zachlambert/pcb-mobile-robot/base/mobile_robot.kicad_pcb

## KiCad design base/mobile_robot.kicad_pcb (2022-08-06)

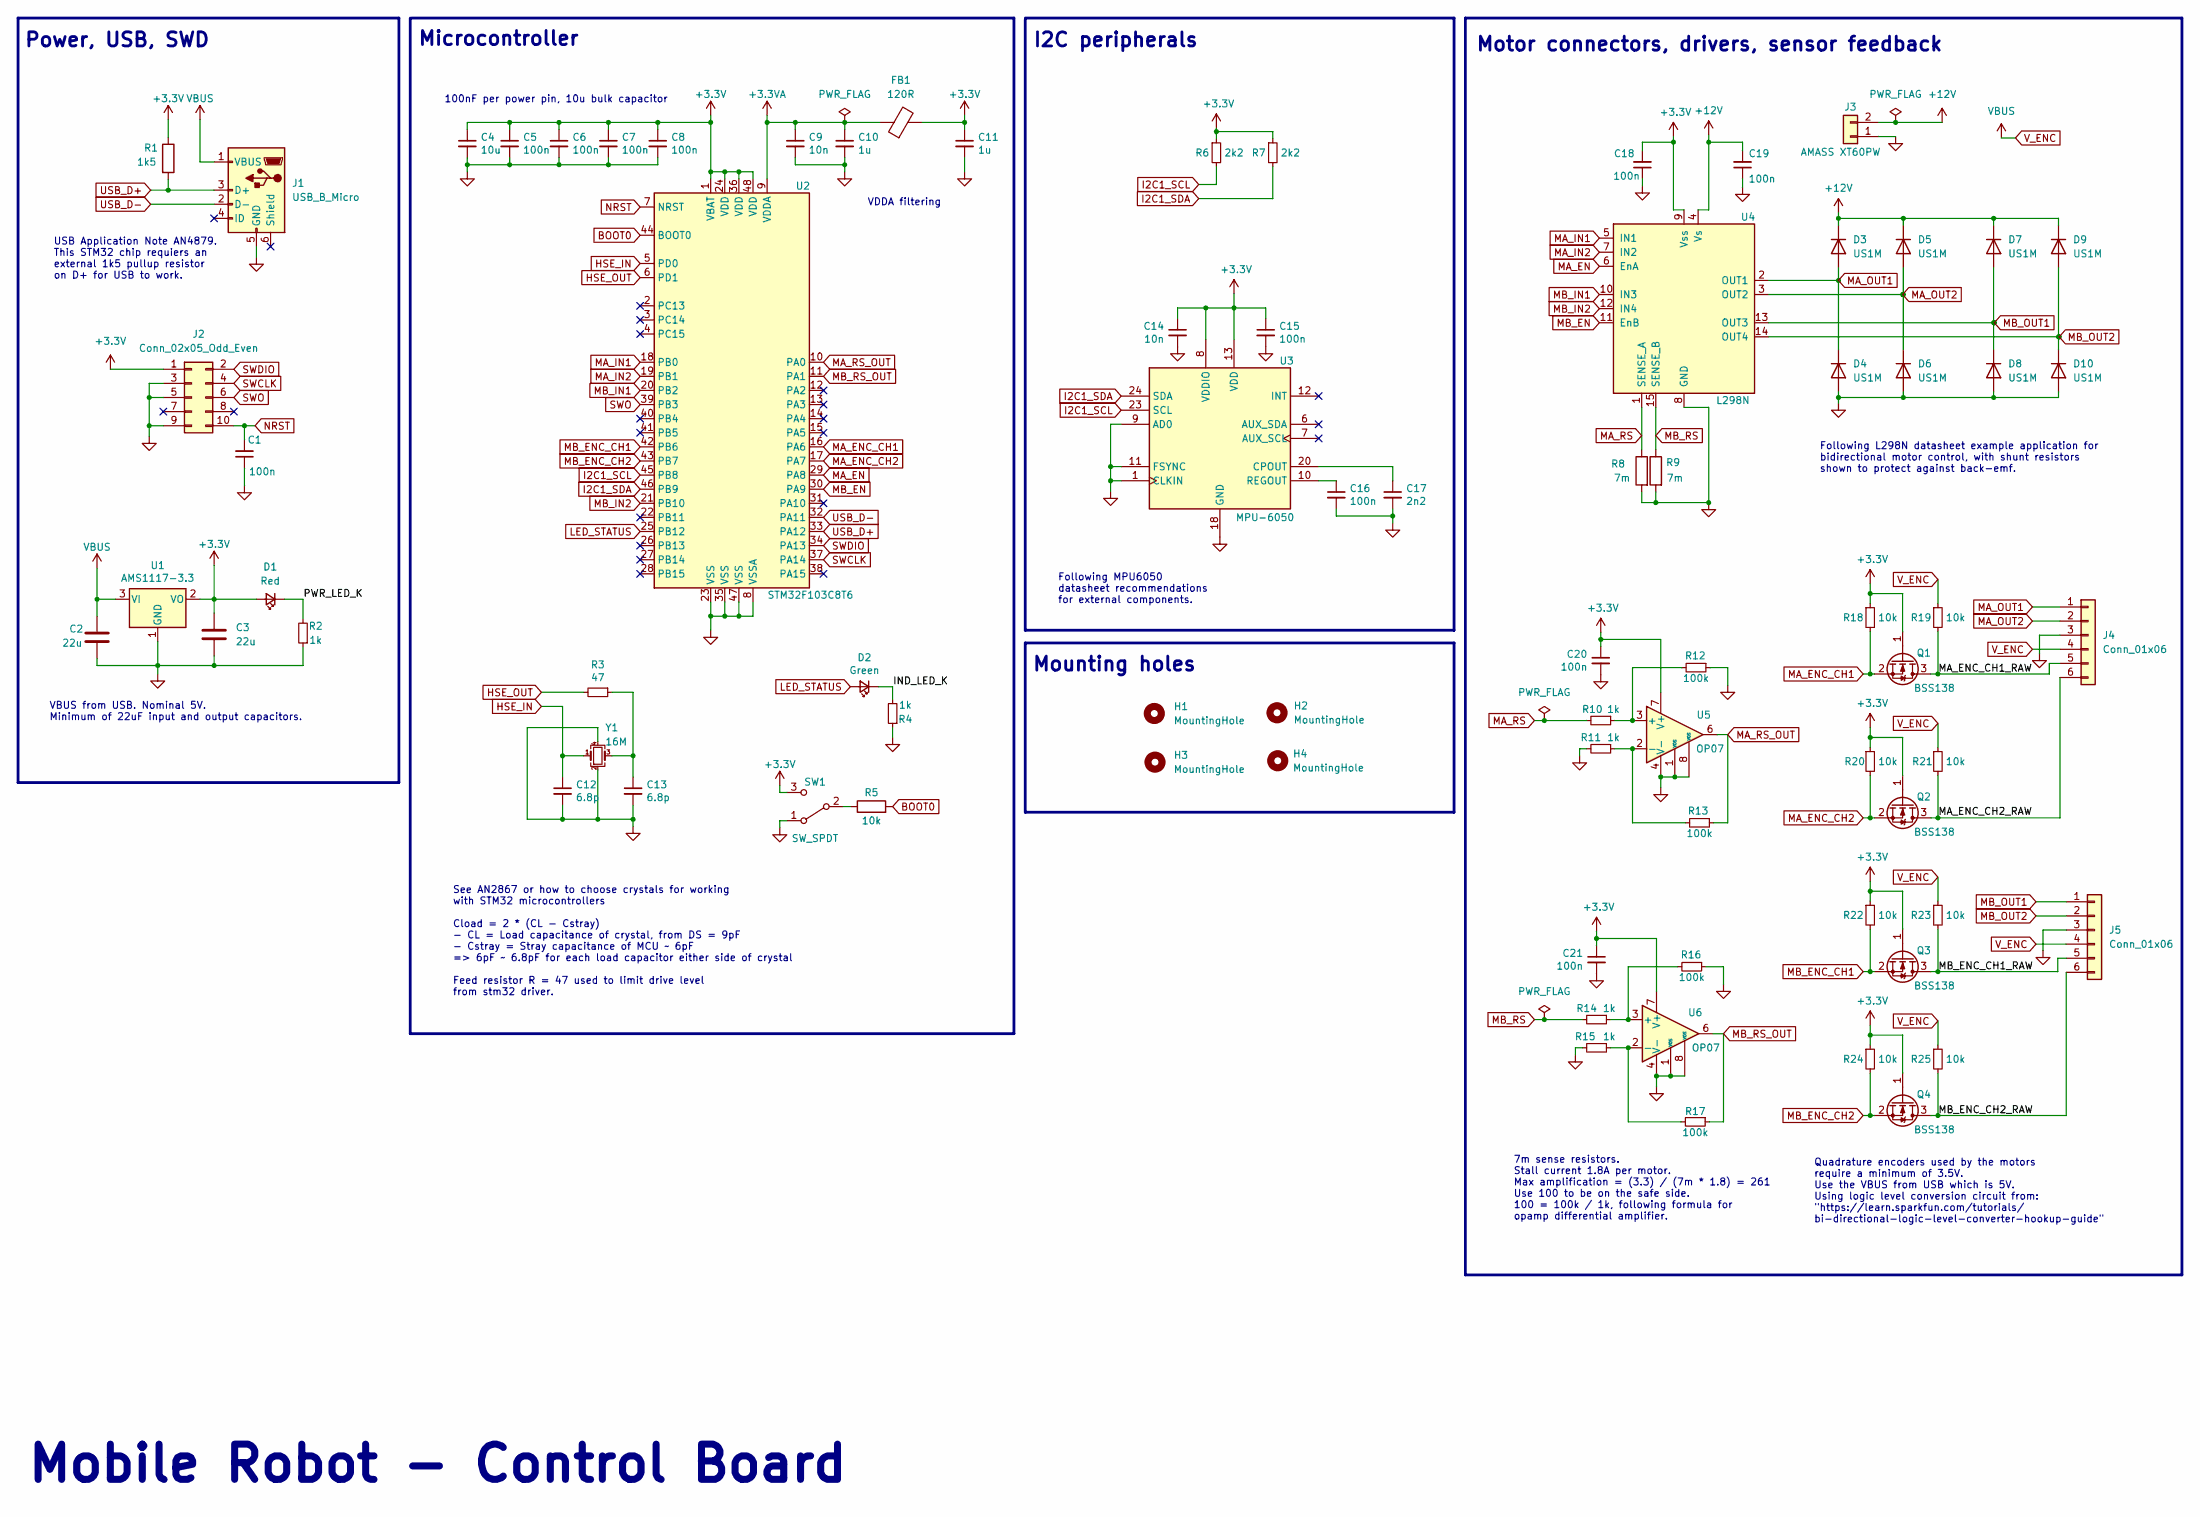
[picture p1: schematic mobile_robot.kicad_sch, Mobile Robot - Control Board]

Parts:
C1, C5, C6, C7, C8, C15, C16, C18, C19, C20, C21: 100n; C_0402_1005Metric
C2, C3: 22u; C_0805_2012Metric
C4: 10u; C_0603_1608Metric
C9, C14: 10n; C_0402_1005Metric
C10, C11: 1u; C_0402_1005Metric
C12, C13: 6.8p; C_0402_1005Metric
C17: 2n2; C_0402_1005Metric
D1: Red; D_0603_1608Metric
D2: Green; D_0603_1608Metric
D3, D4, D5, D6, D7, D8, D9, D10: US1M; D_SMA
FB1: 120R; L_0603_1608Metric
H1, H2, H3, H4: MountingHole; MountingHole_3.2mm_M3
J1: USB_B_Micro; USB_Micro-B_Molex_47346-0001
J2: Conn_02x05_Odd_Even; PinHeader_2x05_P2.54mm_Vertical
J3: AMASS XT60PW; AMASS_XT60PW-M
J4, J5: Conn_01x06; PinHeader_1x06_P2.54mm_Vertical
Q1, Q2, Q3, Q4: BSS138; SOT-23
R1: 1k5; R_0402_1005Metric
R2, R4, R10, R11, R14, R15: 1k; R_0402_1005Metric
R3: 47; R_0402_1005Metric
R5, R18, R19, R20, R21, R22, R23, R24, R25: 10k; R_0402_1005Metric
R6, R7: 2k2; R_0402_1005Metric
R8, R9: 7m; R_2512_6332Metric
R12, R13, R16, R17: 100k; R_0402_1005Metric
SW1: SW_SPDT; SW_SPDT_PCM12
U1: AMS1117-3.3; SOT-223-3_TabPin2
U2: STM32F103C8T6; LQFP-48_7x7mm_P0.5mm
U3: MPU-6050; InvenSense_QFN-24_4x4mm_P0.5mm
U4: L298N; TO-220-15_P2.54x2.54mm_StaggerOdd_Lead4.58mm_Vertical
U5, U6: OP07; SOIC-8_3.9x4.9mm_P1.27mm
Y1: 16M; Crystal_SMD_3225-4Pin_3.2x2.5mm

Connections:
+3.3VA: C9.1, C10.1, FB1.1, U2.9 (VDDA)
+3V3: C3.1, C4.1, C5.1, C6.1, C7.1, C8.1, C11.1, C14.1, C15.1, C18.2, C20.1, C21.1, D1.2 (A), FB1.2, J2.1, Q1.1 (G), Q2.1 (G), Q3.1 (G), Q4.1 (G), R1.1, R6.1, R7.1, R18.1, R20.1, R22.1, R24.1, SW1.3 (C), U1.2 (VO), U2.1 (VBAT), U2.24 (VDD), U2.36 (VDD), U2.48 (VDD), U3.8 (VDDIO), U3.13 (VDD), U4.9 (Vss), U5.7 (V+), U6.7 (V+)
+12V: C19.2, D3.1 (K), D5.1 (K), D7.1 (K), D9.1 (K), J3.2, U4.4 (Vs)
/IND_LED_K: D2.1 (K), R4.2
/MA_ENC_CH1_RAW: J4.5, Q1.3 (D), R19.2
/MA_ENC_CH2_RAW: J4.6, Q2.3 (D), R21.2
/MB_ENC_CH1_RAW: J5.5, Q3.3 (D), R23.2
/MB_ENC_CH2_RAW: J5.6, Q4.3 (D), R25.2
/PWR_LED_K: D1.1 (K), R2.2
BOOT0: R5.2, U2.44 (BOOT0)
GND: C1.1, C2.2, C3.2, C4.2, C5.2, C6.2, C7.2, C8.2, C9.2, C10.2, C11.2, C12.2, C13.2, C14.2, C15.2, C16.2, C17.2, C18.1, C19.1, C20.2, C21.2, D4.2 (A), D6.2 (A), D8.2 (A), D10.2 (A), J1.5 (GND), J2.3, J2.5, J2.9, J3.1, J4.3, J5.3, R2.1, R4.1, R8.2, R9.2, R11.2, R12.1, R15.2, R16.1, SW1.1 (A), U1.1 (GND), U2.8 (VSSA), U2.23 (VSS), U2.35 (VSS), U2.47 (VSS), U3.1 (CLKIN), U3.9 (AD0), U3.11 (FSYNC), U3.18 (GND), U4.8 (GND), U5.1 (VOS), U5.4 (V-), U5.8 (VOS), U6.1 (VOS), U6.4 (V-), U6.8 (VOS), Y1.2, Y1.4
HSE_IN: C12.1, U2.5 (PD0), Y1.1
HSE_OUT: R3.2, U2.6 (PD1)
I2C1_SCL: R6.2, U2.45 (PB8), U3.23 (SCL)
I2C1_SDA: R7.2, U2.46 (PB9), U3.24 (SDA)
LED_STATUS: D2.2 (A), U2.25 (PB12)
MA_EN: U2.29 (PA8), U4.6 (EnA)
MA_ENC_CH1: Q1.2 (S), R18.2, U2.16 (PA6)
MA_ENC_CH2: Q2.2 (S), R20.2, U2.17 (PA7)
MA_IN1: U2.18 (PB0), U4.5 (IN1)
MA_IN2: U2.19 (PB1), U4.7 (IN2)
MA_OUT1: D3.2 (A), D4.1 (K), J4.1, U4.2 (OUT1)
MA_OUT2: D5.2 (A), D6.1 (K), J4.2, U4.3 (OUT2)
MA_RS: R8.1, R10.2, U4.1 (SENSE_A)
MA_RS_OUT: R13.1, U2.10 (PA0), U5.6
MB_EN: U2.30 (PA9), U4.11 (EnB)
MB_ENC_CH1: Q3.2 (S), R22.2, U2.42 (PB6)
MB_ENC_CH2: Q4.2 (S), R24.2, U2.43 (PB7)
MB_IN1: U2.20 (PB2), U4.10 (IN3)
MB_IN2: U2.21 (PB10), U4.12 (IN4)
MB_OUT1: D7.2 (A), D8.1 (K), J5.1, U4.13 (OUT3)
MB_OUT2: D9.2 (A), D10.1 (K), J5.2, U4.14 (OUT4)
MB_RS: R9.1, R14.2, U4.15 (SENSE_B)
MB_RS_OUT: R17.1, U2.11 (PA1), U6.6
NRST: C1.2, J2.10, U2.7 (NRST)
unnamed: C13.1, R3.1, Y1.3
unnamed: C16.1, U3.10 (REGOUT)
unnamed: C17.1, U3.20 (CPOUT)
unnamed: R5.1, SW1.2 (B)
unnamed: R10.1, R12.2, U5.3 (+)
unnamed: R11.1, R13.2, U5.2 (-)
unnamed: R14.1, R16.2, U6.3 (+)
unnamed: R15.1, R17.2, U6.2 (-)
SWCLK: J2.4, U2.37 (PA14)
SWDIO: J2.2, U2.34 (PA13)
SWO: J2.6, U2.39 (PB3)
USB_D+: J1.3 (D+), R1.2, U2.33 (PA12)
USB_D-: J1.2 (D-), U2.32 (PA11)
V_ENC: C2.1, J1.1 (VBUS), J4.4, J5.4, R19.1, R21.1, R23.1, R25.1, U1.3 (VI)

Notes on the sheet:
Motor connectors, drivers, sensor feedback
VDDA filtering
Following MPU6050 datasheet recommendations for external components.
I2C peripherals
Mounting holes
100nF per power pin, 10u bulk capacitor
Microcontroller
7m sense resistors. Stall current 1.8A per motor. Max amplification = (3.3) / (7m * 1.8) = 261 Use 100 to be on the safe side. 100 = 100k / 1k, following formula for opamp differential amplifier.
Mobile Robot - Control Board
Power, USB, SWD
Following L298N datasheet example application for bidirectional motor control, with shunt resistors shown to protect against back-emf.
See AN2867 or how to choose crystals for working with STM32 microcontrollers Cload = 2 * (CL - Cstray) - CL = Load capacitance of crystal, from DS = 9pF - Cstray = Stray capacitance of MCU ~ 6pF => 6pF ~ 6.8pF for each load capacitor either side of crystal Feed resistor R = 47 used to limit drive l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
VBUS from USB. Nominal 5V. Minimum of 22uF input and output capacitors.
USB Application Note AN4879. This STM32 chip requiers an external 1k5 pullup resistor on D+ for USB to work.
Quadrature encoders used by the motors require a minimum of 3.5V. Use the VBUS from USB which is 5V. Using logic level conversion circuit from: "https://learn.sparkfun.com/tutorials/ bi-directional-logic-level-converter-hookup-guide"

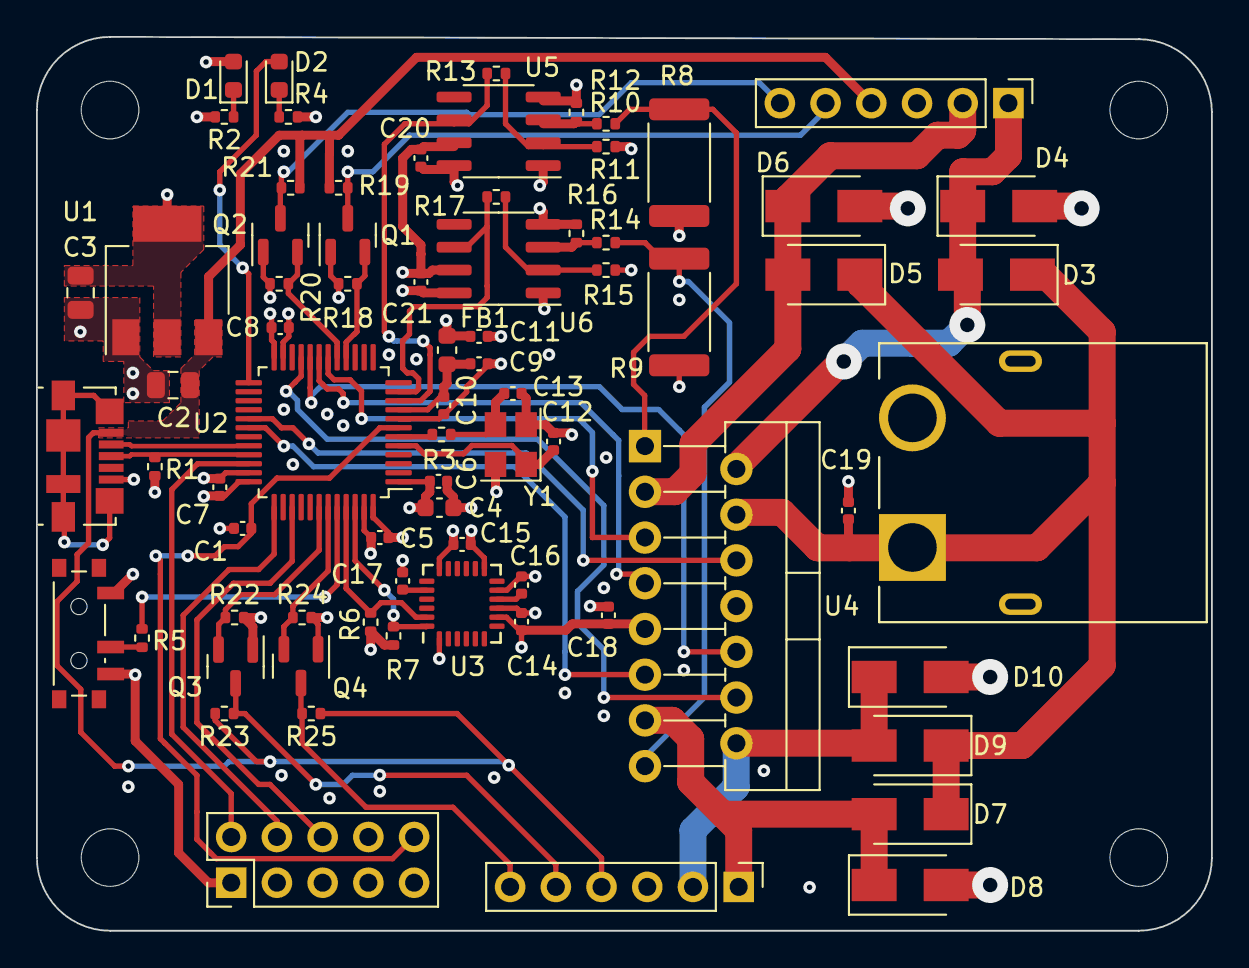
[picture p2: board mobile_robot.kicad_pcb from above]

Board: 4 copper layers, 65.3 x 49.7 mm, 78 parts (0 on the bottom side), 49 nets.
