zachlambert/pcb-mobile-robot/(commit log)

2022-08-02 Finished schematic and initial component placement on pcb
    [mobile_robot.kicad_pcb, mobile_robot.kicad_sch]
2022-08-05 Pretty much finished pcb layout and routing
    [mobile_robot.kicad_pcb, mobile_robot.kicad_sch]
2022-08-05 Did usb differential pair properly
    [mobile_robot.kicad_pcb]
2022-08-06 Finished PCB
    [mobile_robot.kicad_pcb, mobile_robot.kicad_sch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]
